particlecluster/8-Bit-Pipelined-Microprocessor/docs/Architecture_Diagram.png

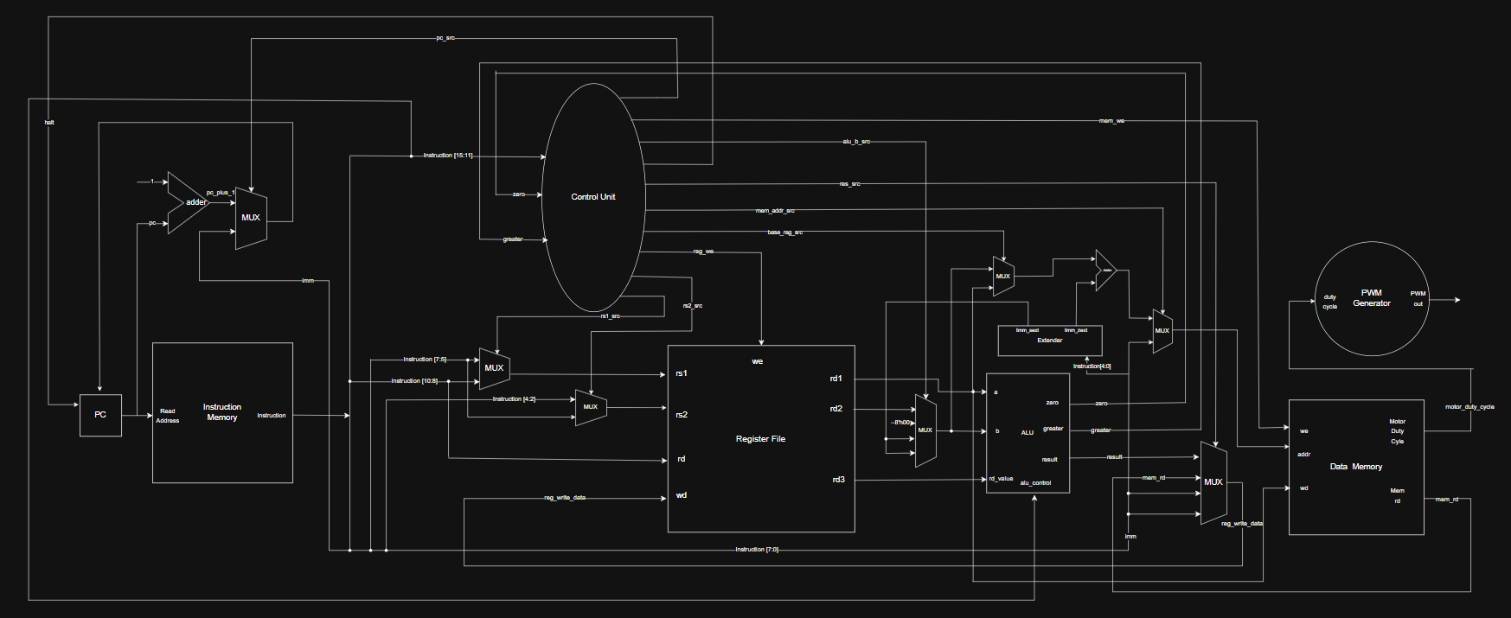
docs/Architecture_Diagram.png
