particlecluster/8-Bit-Pipelined-Microprocessor/(commit log)

2026-06-06 Fix PASS/MOV operation to forward B input
    Corrected the result assignment for the PASS/MOV operation to use 'b' instead of 'a'.
    [alu.v]
2026-06-10 Add store_rs2 and store_data wires for CPU logic
2026-06-18 Implement complete CPU architecture with upgrades
    This commit introduces a complete CPU design with upgraded components including a Program Counter, ALU with hardware multiplier and rotates, upgraded Register File with three read ports, Data Memory with MMIO support, Instruction Memory, Control Unit, and a PWM Generator.
2026-06-22 Create web assembler HTML layout and functionality
2026-06-24 Update title and enhance styling for assembler
2026-06-26 Refactor web assembler layout and styles
    Updated the title and styles for better aesthetics. Enhanced the layout and improved the assembly input and output sections.
2026-06-30 Add assembly instructions for ALU operations
2026-07-31 Add InterruptController module for handling interrupts
2026-07-31 Refactor PWM_Generator to use parameterized data width
2026-07-31 Add UART peripheral module with transmitter and receiver
2026-08-03 Modify branch predictor reset logic
    Reset branch predictor state on reset signal.
    [branch_pred.v]
2026-08-15 docs: rewrite README with hardware setup, wiring tables, fluid physics & program.hex.txt explanation
2026-08-15 docs: correct LED matrix description to 2x2 spirit level dot (not 3x3 fluid physics)
2026-08-15 feat: restore 3x3 viscous water drop + auto-calibration as active build; update README accordingly
